gfcwfzkm/tt09-scope-bfh-mht1_3/docs/Blockschaltbild_DSO.png

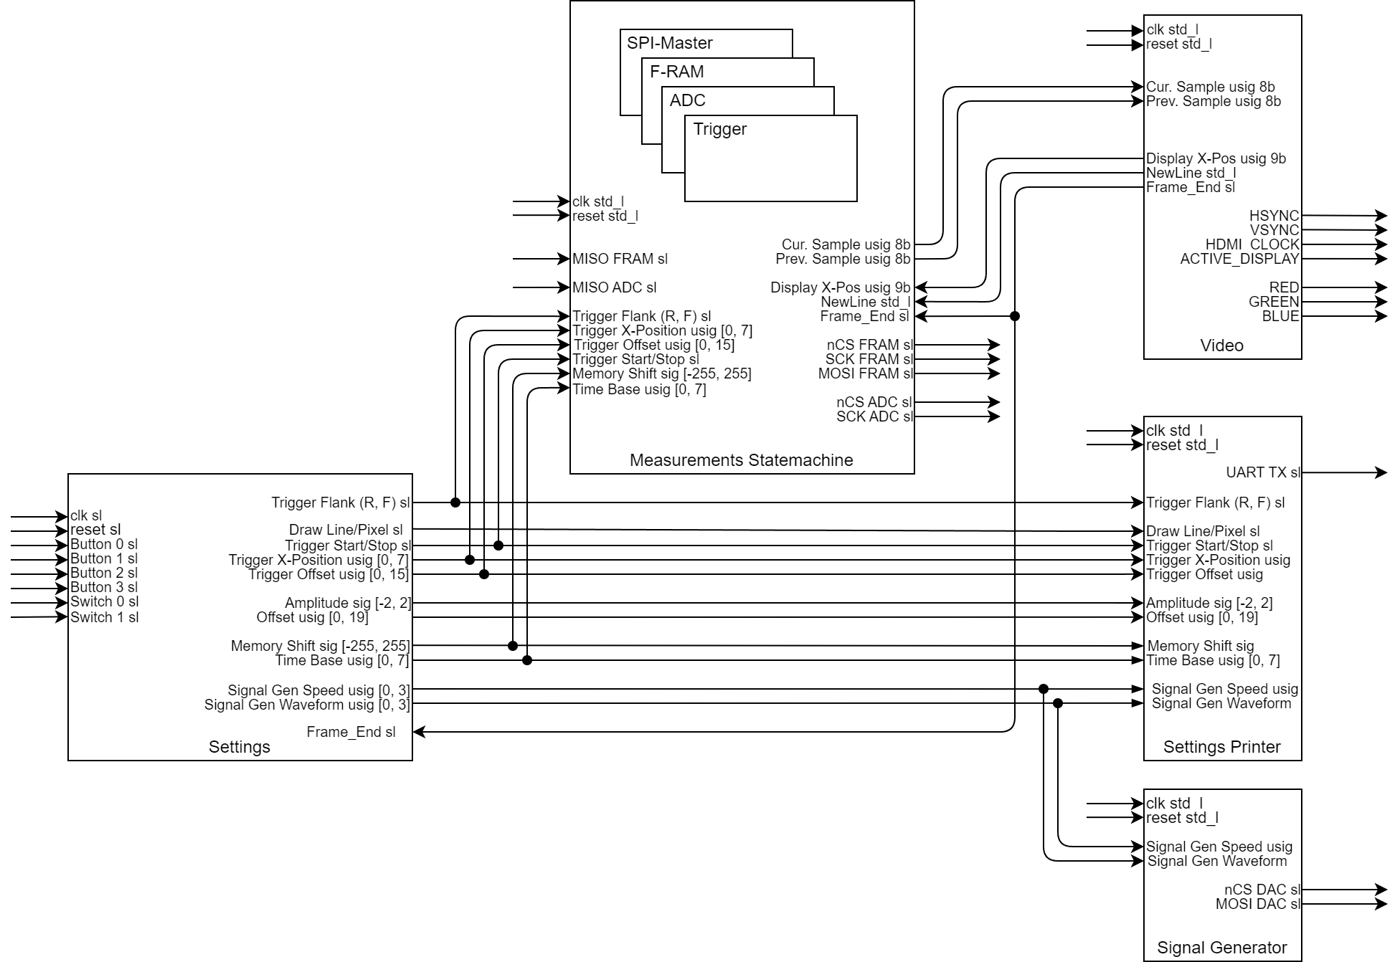
docs/Blockschaltbild_DSO.png
