gfcwfzkm/tt09-scope-bfh-mht1_3/TerosHDL.yaml

name: Tiny Tapeout Scope
project_disk_path: ''
project_type: genericProject
toplevel: src\tt_um_gfcwfzkm_scope_bfh_mht1_3.vhdl
files:
  - name: src\tt_um_gfcwfzkm_scope_bfh_mht1_3.vhdl
    file_type: vhdlSource
    file_version: '2008'
    is_include_file: false
    include_path: ''
    logical_name: ''
    is_manual: true
    source_type: synthesis
  - name: src\video\video.vhdl
    file_type: vhdlSource
    file_version: '2008'
    is_include_file: false
    include_path: ''
    logical_name: ''
    is_manual: true
    source_type: synthesis
  - name: src\video\vtgen.vhdl
    file_type: vhdlSource
    file_version: '2008'
    is_include_file: false
    include_path: ''
    logical_name: ''
    is_manual: true
    source_type: synthesis
  - name: src\video\image_generators\channel_gen.vhdl
    file_type: vhdlSource
    file_version: '2008'
    is_include_file: false
    include_path: ''
    logical_name: ''
    is_manual: true
    source_type: synthesis
  - name: src\video\image_generators\grid_gen.vhdl
    file_type: vhdlSource
    file_version: '2008'
    is_include_file: false
    include_path: ''
    logical_name: ''
    is_manual: true
    source_type: synthesis
  - name: src\video\image_generators\merge_generators.vhdl
    file_type: vhdlSource
    file_version: '2008'
    is_include_file: false
    include_path: ''
    logical_name: ''
    is_manual: true
    source_type: synthesis
  - name: src\video\image_generators\trigger_gen.vhdl
    file_type: vhdlSource
    file_version: '2008'
    is_include_file: false
    include_path: ''
    logical_name: ''
    is_manual: true
    source_type: synthesis
  - name: src\signal_gen\pmodDA2.vhdl
    file_type: vhdlSource
    file_version: '2008'
    is_include_file: false
    include_path: ''
    logical_name: ''
    is_manual: true
    source_type: synthesis
  - name: src\signal_gen\signal_gen.vhdl
    file_type: vhdlSource
    file_version: '2008'
    is_include_file: false
    include_path: ''
    logical_name: ''
    is_manual: true
    source_type: synthesis
  - name: src\signal_gen\waveforms\rectangle.vhdl
    file_type: vhdlSource
    file_version: '2008'
    is_include_file: false
    include_path: ''
    logical_name: ''
    is_manual: true
    source_type: synthesis
  - name: src\signal_gen\waveforms\sawtooth.vhdl
    file_type: vhdlSource
    file_version: '2008'
    is_include_file: false
    include_path: ''
    logical_name: ''
    is_manual: true
    source_type: synthesis
  - name: src\signal_gen\waveforms\sine.vhdl
    file_type: vhdlSource
    file_version: '2008'
    is_include_file: false
    include_path: ''
    logical_name: ''
    is_manual: true
    source_type: synthesis
  - name: src\signal_gen\waveforms\triangle.vhdl
    file_type: vhdlSource
    file_version: '2008'
    is_include_file: false
    include_path: ''
    logical_name: ''
    is_manual: true
    source_type: synthesis
  - name: src\settings\debouncer.vhdl
    file_type: vhdlSource
    file_version: '2008'
    is_include_file: false
    include_path: ''
    logical_name: ''
    is_manual: true
    source_type: synthesis
  - name: src\settings\settings.vhdl
    file_type: vhdlSource
    file_version: '2008'
    is_include_file: false
    include_path: ''
    logical_name: ''
    is_manual: true
    source_type: synthesis
  - name: src\serial_out\print_settings.vhdl
    file_type: vhdlSource
    file_version: '2008'
    is_include_file: false
    include_path: ''
    logical_name: ''
    is_manual: true
    source_type: synthesis
  - name: src\serial_out\uart_tx.vhdl
    file_type: vhdlSource
    file_version: '2008'
    is_include_file: false
    include_path: ''
    logical_name: ''
    is_manual: true
    source_type: synthesis
  - name: src\measurements\measurement_sm.vhdl
    file_type: vhdlSource
    file_version: '2008'
    is_include_file: false
    include_path: ''
    logical_name: ''
    is_manual: true
    source_type: synthesis
  - name: src\measurements\trigger_detection.vhdl
    file_type: vhdlSource
    file_version: '2008'
    is_include_file: false
    include_path: ''
    logical_name: ''
    is_manual: true
    source_type: synthesis
  - name: src\measurements\samples_memory\fram.vhdl
    file_type: vhdlSource
    file_version: '2008'
    is_include_file: false
    include_path: ''
    logical_name: ''
    is_manual: true
    source_type: synthesis
  - name: src\measurements\samples_memory\spi_master.vhdl
    file_type: vhdlSource
    file_version: '2008'
    is_include_file: false
    include_path: ''
    logical_name: ''
    is_manual: true
    source_type: synthesis
  - name: src\measurements\adc\pmodAD1.vhdl
    file_type: vhdlSource
    file_version: '2008'
    is_include_file: false
    include_path: ''
    logical_name: ''
    is_manual: true
    source_type: synthesis
  - name: test\vhdl\debouncer_tb.vhdl
    file_type: vhdlSource
    file_version: '2008'
    is_include_file: false
    include_path: ''
    logical_name: ''
    is_manual: true
    source_type: simulation
  - name: test\vhdl\fram_tb.vhdl
    file_type: vhdlSource
    file_version: '2008'
    is_include_file: false
    include_path: ''
    logical_name: ''
    is_manual: true
    source_type: simulation
  - name: test\vhdl\pmodAD1_tb.vhdl
    file_type: vhdlSource
    file_version: '2008'
    is_include_file: false
    include_path: ''
    logical_name: ''
    is_manual: true
    source_type: simulation
  - name: test\vhdl\pmodDA2_tb.vhdl
    file_type: vhdlSource
    file_version: '2008'
    is_include_file: false
    include_path: ''
    logical_name: ''
    is_manual: true
    source_type: simulation
  - name: test\vhdl\spi_master_tb.vhdl
    file_type: vhdlSource
    file_version: '2008'
    is_include_file: false
    include_path: ''
    logical_name: ''
    is_manual: true
    source_type: simulation
  - name: test\vhdl\uart_tx_tb.vhdl
    file_type: vhdlSource
    file_version: '2008'
    is_include_file: false
    include_path: ''
    logical_name: ''
    is_manual: true
    source_type: simulation
  - name: test\vhdl\video_tb.vhdl
    file_type: vhdlSource
    file_version: '2008'
    is_include_file: false
    include_path: ''
    logical_name: ''
    is_manual: true
    source_type: simulation
  - name: test\vhdl\waveform_test.vhdl
    file_type: vhdlSource
    file_version: '2008'
    is_include_file: false
    include_path: ''
    logical_name: ''
    is_manual: true
    source_type: simulation
hooks:
  pre_build: []
  post_build: []
  pre_run: []
  post_run: []
watchers: []
configuration:
  general:
    general:
      pypath: 'C:\users\pasca\teroshdl_pythonvenv\scripts\'
      makepath: ''
      go_to_definition_vhdl: true
      go_to_definition_verilog: true
      developer_mode: false
  documentation:
    general:
      language: english
      symbol_vhdl: '!'
      symbol_verilog: '!'
      dependency_graph: true
      self_contained: true
      fsm: true
      ports: all
      generics: all
      instantiations: all
      signals: all
      constants: all
      types: all
      process: all
      functions: all
      tasks: all
      magic_config_path: ''
  editor:
    general:
      stutter_comment_shortcuts: false
      stutter_block_width: 80
      stutter_max_width: 0
      stutter_delimiters: false
      stutter_bracket_shortcuts: false
  formatter:
    general:
      formatter_verilog: istyle
      formatter_vhdl: standalone
    istyle:
      style: ansi
      indentation_size: 2
    s3sv:
      one_bind_per_line: false
      one_declaration_per_line: false
      use_tabs: true
      indentation_size: 2
    verible:
      format_args: ''
    standalone:
      keyword_case: lowercase
      name_case: lowercase
      indentation: '  '
      align_port_generic: true
      align_comment: false
      remove_comments: false
      remove_reports: false
      check_alias: false
      new_line_after_then: new_line
      new_line_after_semicolon: new_line
      new_line_after_else: new_line
      new_line_after_port: new_line
      new_line_after_generic: new_line
    svg:
      configuration: ''
      core_number: 2
      aditional_arguments: ''
  linter:
    general:
      linter_vhdl: none
      linter_verilog: disabled
      lstyle_verilog: disabled
      lstyle_vhdl: disabled
    ghdl:
      arguments: ''
    icarus:
      arguments: ''
    modelsim:
      vhdl_arguments: ''
      verilog_arguments: ''
    verible:
      arguments: ''
    verilator:
      arguments: ''
    vivado:
      vhdl_arguments: ''
      verilog_arguments: ''
    vsg:
      arguments: ''
  schematic:
    general:
      backend: yosys_ghdl
      extra: ''
      args: ''
      args_ghdl: ''
  templates:
    general:
      header_file_path: ''
      indent: '  '
      clock_generation_style: inline
      instance_style: inline
  tools:
    general:
      select_tool: modelsim
      manual_compilation_order: ''
      execution_mode: cmd
      waveform_viewer: tool
      gtkwave_installation_path: ''
      gtkwave_extra_arguments: ''
    quartus:
      installation_path: 'C:\intelFPGA_lite\18.1\quartus\bin64'
      family: Cyclone10 LP
      device: 10CL016YF484C6G
      optimization_mode: BALANCED
      allow_register_retiming: true
      wave_file_questa: ''
    osvvm:
      installation_path: ''
      tclsh_binary: ''
      simulator_name: ghdl
    ascenlint:
      installation_path: ''
      ascentlint_options: []
    cocotb:
      installation_path: 'C:\Users\pasca\TerosHDL_PythonVENV\Lib\site-packages\cocotb'
      simulator_name: modelsim
      compile_args: ''
      run_args: ''
      plusargs: ''
    diamond:
      installation_path: ''
      part: ''
    ghdl:
      installation_path: 'C:\msys64\mingw64\bin'
      waveform: vcd
      analyze_options: []
      run_options: []
    icarus:
      installation_path: ''
      timescale: ''
      iverilog_options: []
    icestorm:
      installation_path: ''
      pnr: none
      arch: xilinx
      output_format: json
      yosys_as_subtool: false
      makefile_name: ''
      arachne_pnr_options: []
      nextpnr_options: []
      yosys_synth_options: []
    ise:
      installation_path: ''
      family: ''
      device: ''
      package: ''
      speed: ''
    isem:
      installation_path: ''
      fuse_options: []
      isim_options: []
    modelsim:
      installation_path: 'C:\intelFPGA_lite\18.1\modelsim_ase\win32aloem'
      vcom_options: []
      vlog_options: []
      vsim_options: []
    morty:
      installation_path: ''
      morty_options: []
    radiant:
      installation_path: ''
      part: ''
    rivierapro:
      installation_path: ''
      compilation_mode: ''
      vlog_options: []
      vsim_options: []
    spyglass:
      installation_path: ''
      methodology: ''
      goals: []
      spyglass_options: []
      rule_parameters: []
    symbiyosys:
      installation_path: ''
      tasknames: []
    symbiflow:
      installation_path: ''
      package: ''
      part: ''
      vendor: ''
      pnr: vpr
      vpr_options: ''
      environment_script: ''
    trellis:
      installation_path: ''
      arch: xilinx
      output_format: json
      yosys_as_subtool: false
      makefile_name: ''
      script_name: ''
      nextpnr_options: []
      yosys_synth_options: []
    vcs:
      installation_path: ''
      vcs_options: []
      run_options: []
    verible:
      installation_path: ''
    verilator:
      installation_path: ''
      mode: lint-only
      libs: []
      verilator_options: []
      make_options: []
      run_options: []
    vivado:
      installation_path: ''
      part: ''
      synth: ''
      pnr: vivado
      jtag_freq: 10000
      hw_target: ''
    vunit:
      installation_path: 'C:\Users\pasca\TerosHDL_PythonVENV\Lib\site-packages\vunit'
      simulator_name: ghdl
      runpy_mode: standalone
      extra_options: ''
      enable_array_util_lib: false
      enable_com_lib: false
      enable_json4vhdl_lib: false
      enable_osvvm_lib: false
      enable_random_lib: false
      enable_verification_components_lib: false
    xcelium:
      installation_path: ''
      xmvhdl_options: []
      xmvlog_options: []
      xmsim_options: []
      xrun_options: []
    xsim:
      installation_path: ''
      xelab_options: []
      xsim_options: []
    yosys:
      installation_path: 'C:\msys64\mingw64\bin'
      arch: xilinx
      output_format: json
      yosys_as_subtool: false
      makefile_name: ''
      script_name: ''
      yosys_synth_options: []
    openfpga:
      installation_path: ''
      arch: ''
      task_options: []
    activehdl:
      installation_path: ''
    questa:
      installation_path: ''
    raptor:
      installation_path: ''
      target_device: 1GE100
      vhdl_version: VHDL_1993
      verilog_version: V_2001
      sv_version: SV_2012
      optimization: none
      effort: high
      fsm_encoding: onehot
      carry: auto
      pnr_netlist_language: verilog
      dsp_limit: 154
      block_ram_limit: 154
      fast_synthesis: false
      top_level: ''
      sim_source_list: []
      simulate_rtl: false
      waveform_rtl: syn_tb_rtl.fst
      simulator_rtl: ghdl
      simulation_options_rtl: '--stop-time=1000ns'
      simulate_gate: false
      waveform_gate: syn_tb_gate.fst
      simulator_gate: ghdl
      simulation_options_gate: '--stop-time=1000ns'
      simulate_pnr: false
      waveform_pnr: sim_pnr.fst
      simulator_pnr: ghdl
      simulation_options_pnr: '--stop-time=1000ns'
tool_options:
  modelsim:
    name: modelsim
    installation_path: 'C:\intelFPGA_lite\18.1\modelsim_ase\win32aloem'
    config:
      installation_path: 'C:\intelFPGA_lite\18.1\modelsim_ase\win32aloem'
      vcom_options: []
      vlog_options: []
      vsim_options: []
