gfcwfzkm/tt09-scope-bfh-mht1_3/src/video/image_generators/trigger_gen.vhdl

-- TerosHDL Documentation:
--! @title Trigger Generator
--! @author Pascal Gesell (gesep1 / gfcwfzkm)
--! @version 1.0
--! @date 09.10.2024
--! @brief Generates a trigger signal based on the display position.
--!
--! This module generates an active signal when the display pointer (x,y) is at the trigger
--! position to be rendered.
--!

library ieee;
use ieee.std_logic_1164.all;
use ieee.numeric_std.all;
use ieee.math_real.all;

entity trigger_gen is
	generic (
		--! HDMI Horizontal Bitwidth
		c_HDMI_H_BITWIDTH	: positive := 10;
		--! HDMI Vertical Bitwidth
		c_HDMI_V_BITWIDTH	: positive := 10;
		--! Maximum Y position of the display
		c_DISPLAY_Y_MAX		: positive := 640;
		--! Minimum X position of the trigger
		c_TRIGGER_X_POS_MIN : positive := 480-32;
		--! Minimum Y position of the trigger
		c_TRIGGER_Y_POS_MIN : positive := 640-32;
		--! Trigger X position step
		c_TRIGGER_X_STEP : positive := 60
	);
	port (
		--! X Position of Display
		disp_x		: in unsigned(c_HDMI_H_BITWIDTH-1 downto 0);
		--! Y Position of Display
		disp_y		: in unsigned(c_HDMI_V_BITWIDTH-1 downto 0);

		--! Trigger Horizontal Position
		triggerXPos : unsigned(2 downto 0);
		--! Trigger Vertical Position
		triggerYPos : unsigned(3 downto 0);
		--! Channel Offset
		chOffset : in unsigned(4 downto 0);
		--! Channel Amplitude
		chAmplitude : in signed(2 downto 0);

		--! Output of active signal
		trigger_active	: out std_logic
	);
end entity trigger_gen;

architecture rtl of trigger_gen is
	--! Trigger X position calculated (triggerXPos * 60)
	signal triggerXPos_calced : unsigned(c_HDMI_H_BITWIDTH-1 downto 0);
	--! Trigger Y position calculated (triggerYPos * 16)
	signal triggerYPos_shifted : unsigned(c_HDMI_V_BITWIDTH downto 0);
	--! Trigger Y position amplified (triggerYPos_shifted * 2^chAmplitude)
	signal triggerYPos_amplified : unsigned(c_HDMI_V_BITWIDTH downto 0);
	--! Trigger Y position calculated (triggerYPos_amplified + channelOffset_calced)
	signal triggerYPos_calced : unsigned(c_HDMI_V_BITWIDTH downto 0);
	--! Trigger Y position final (if the calculated position is out of bounds, set to the maximum)
	signal triggerYPos_final : unsigned(c_HDMI_V_BITWIDTH-1 downto 0);
	--! Channel offset calculated (chOffset * 32)
	signal channelOffset_calced : unsigned(c_HDMI_V_BITWIDTH downto 0);
	--! Active signal for the X position
	signal trigger_active_x : std_logic;
	--! Active signal for the Y position
	signal trigger_active_y : std_logic;
begin

	-- Calculate the channel offset by multiplying it by 32 (offset moves in 32 pixel steps)
	channelOffset_calced <= shift_left(resize(chOffset, c_HDMI_V_BITWIDTH+1), 5);
	-- Shift the trigger Y position to the left by 4 bits (multiply by 16)
	triggerYPos_shifted <= shift_left(resize(triggerYPos, c_HDMI_V_BITWIDTH+1), 4);

	-- Amplify the trigger Y position by the channel amplitude
	triggerYpos_amplified <= shift_right(triggerYPos_shifted, to_integer(-chAmplitude)) when chAmplitude < 0 else
							 triggerYPos_shifted										when chAmplitude = 0 else
							 shift_left(triggerYPos_shifted, to_integer(chAmplitude));

	-- Calculate the final trigger Y position by adding the channel offset
	triggerYPos_calced <= triggerYPos_amplified + channelOffset_calced;
	-- If the calculated position is out of bounds, set it to the maximum
	triggerYPos_final <= triggerYPos_calced(c_HDMI_V_BITWIDTH-1 downto 0) when triggerYPos_calced(c_HDMI_V_BITWIDTH) = '0' else
						 to_unsigned(c_DISPLAY_Y_MAX-1, c_HDMI_V_BITWIDTH);

	-- Calculate the trigger X position by multiplying it with 60
	triggerXPos_calced <= to_unsigned(c_TRIGGER_X_STEP, c_HDMI_H_BITWIDTH - triggerXPos'length) * triggerXPos;

	-- Set the active signal for the X and Y position
	trigger_active_x <= '1' when disp_x = triggerXPos_calced and disp_y > c_TRIGGER_Y_POS_MIN else '0';
	trigger_active_y <= '1' when disp_y = triggerYPos_calced and disp_x > c_TRIGGER_X_POS_MIN else '0';

	-- Set the active signal to the OR of the X and Y position
	trigger_active <= trigger_active_x or trigger_active_y;

end architecture;
