gfcwfzkm/tt09-scope-bfh-mht1_3/fpga/gowin_vhdl_tang9k/src/gowin_rpll/gowin_rpll_tmp.vhd

--Copyright (C)2014-2024 Gowin Semiconductor Corporation.
--All rights reserved.
--File Title: Template file for instantiation
--Tool Version: V1.9.10.02
--Part Number: GW1NR-LV9QN88PC6/I5
--Device: GW1NR-9
--Device Version: C
--Created Time: Tue Oct  8 16:26:31 2024

--Change the instance name and port connections to the signal names
----------Copy here to design--------

component Gowin_rPLL
    port (
        clkout: out std_logic;
        clkin: in std_logic
    );
end component;

your_instance_name: Gowin_rPLL
    port map (
        clkout => clkout,
        clkin => clkin
    );

----------Copy end-------------------
