gfcwfzkm/tt09-scope-bfh-mht1_3/(commit log)

2024-10-07 Initial push of the current project state
2024-10-08 Prototype to read from FRAM, needs testing
2024-10-09 Added FPGA prototype project, crude sample-memory system
2024-10-09 workaround for ghdl naming conversion
    [measurement_sm.vhdl]
2024-10-11 Prototype signal generator, testing needed
2024-10-13 Sampling works, Signal generator works
    [device.cfg]
2024-10-14 Deleted old FPGA folder, updated project information, added UART
    [device.cfg]
2024-10-26 Syncronized the button/switches inputs
2024-11-09 Fixed some errors caused with the refactoring / code review
    [measurement_sm.vhdl, pmodAD1.vhdl, pmodDA2.vhdl, print_settings.vhdl, signal_gen.vhdl, spi_master.vhdl]
2024-11-24 Fixed some comments regarding the trigger position
    [measurement_sm.vhdl, settings.vhdl, trigger_gen.vhdl]
